AZOMC/fyp-robotic-weed-control/assets/detections_sample.jpg

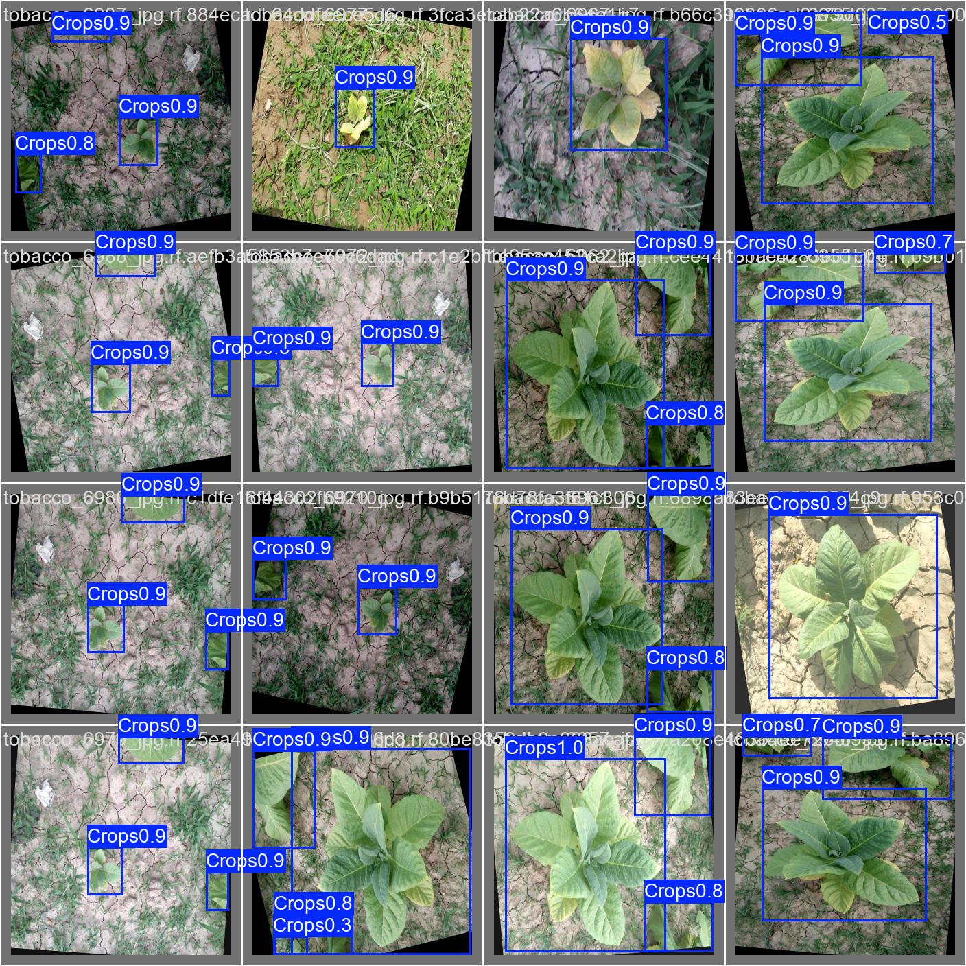
assets/detections_sample.jpg
