AZOMC/fyp-robotic-weed-control/assets/f1_curve.png

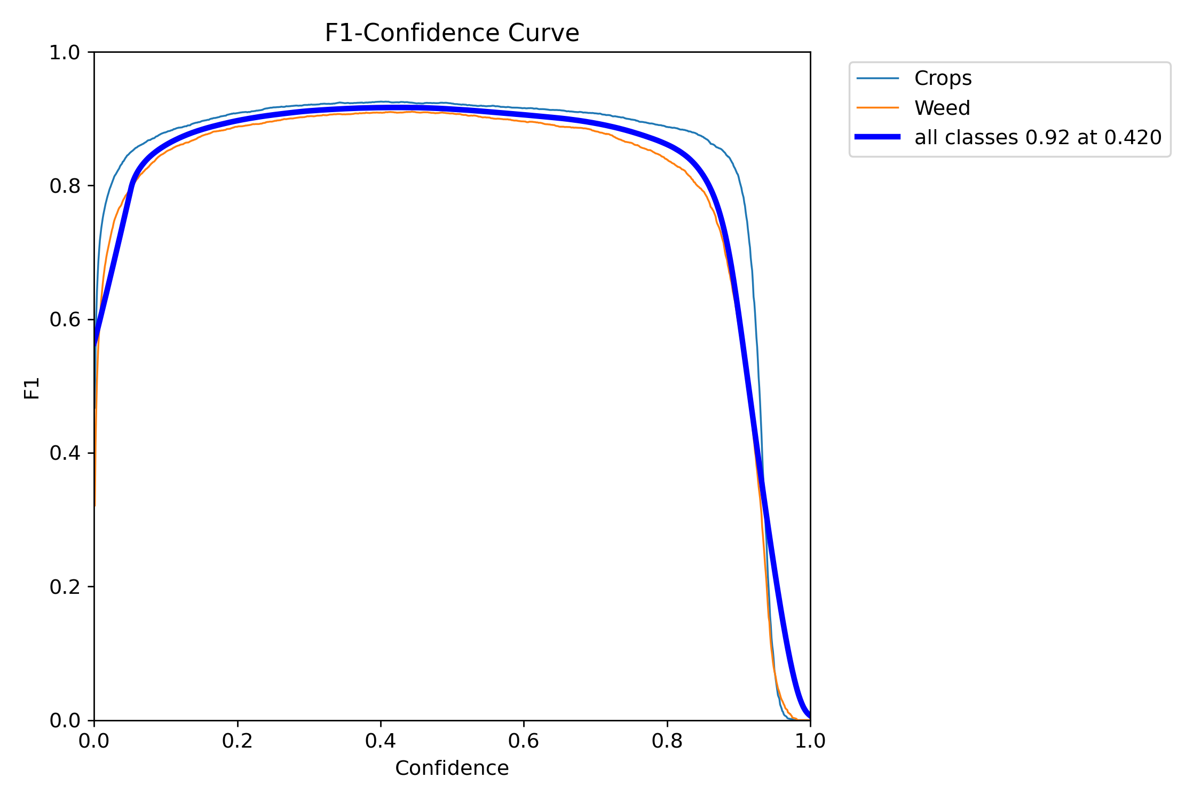
assets/f1_curve.png
