AZOMC/fyp-robotic-weed-control/assets/project_flowchart.png

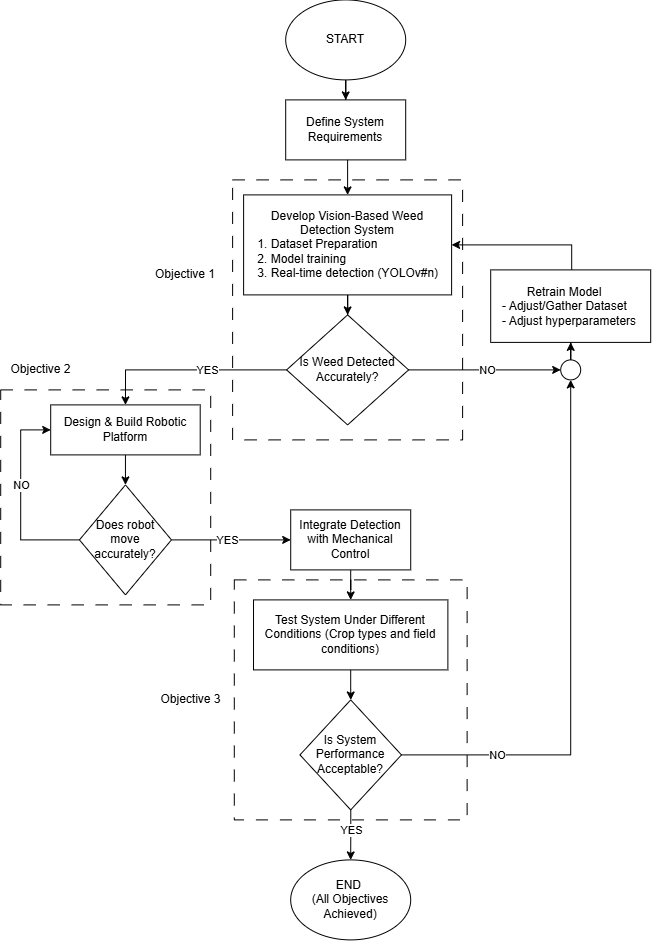
assets/project_flowchart.png
