AZOMC/fyp-robotic-weed-control/assets/training_curves.png

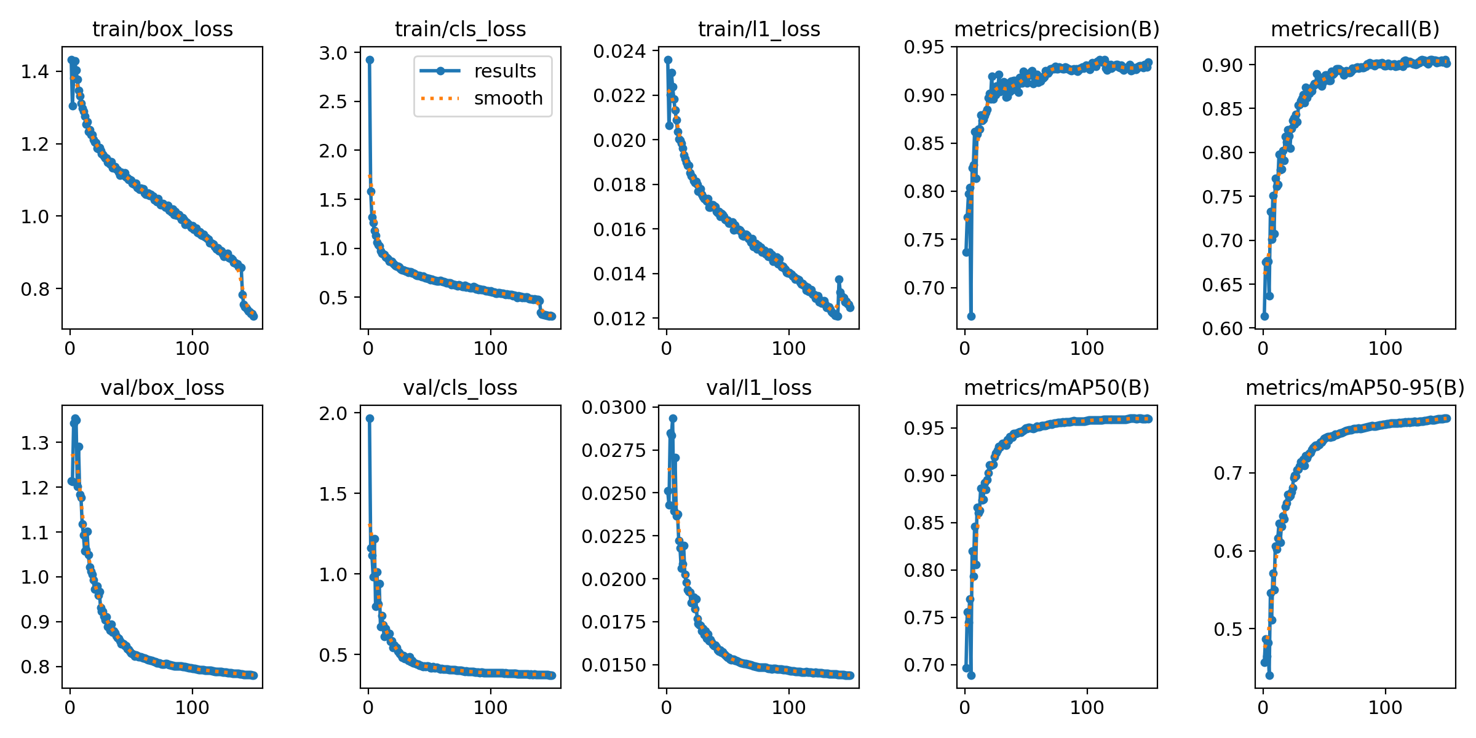
assets/training_curves.png
