AZOMC/fyp-robotic-weed-control/docs/benchmark_results_clean_power.csv

label | imgsz | avg_ms | min_ms | max_ms | fps
v2_ncnn_320 | 320 | 101.49 | 100.45 | 107.17 | 9.85
v2_ncnn_640 | 640 | 398.34 | 387.78 | 413.93 | 2.51
v3_ncnn_320 | 320 | 95.67 | 92.49 | 124.79 | 10.45
v3_onnx_320 | 320 | 105.23 | 102.92 | 119.07 | 9.50
