AZOMC/fyp-robotic-weed-control/docs/training_results_yolo11n.csv

epoch | time | train/box_loss | train/cls_loss | train/dfl_loss | metrics/precision(B) | metrics/recall(B) | metrics/mAP50(B) | metrics/mAP50-95(B) | val/box_loss | val/cls_loss | val/dfl_loss | lr/pg0 | lr/pg1 | lr/pg2 | lr/pg3 | lr/pg4 | lr/pg5 | lr/pg6 | lr/pg7
1 | 84.466 | 1.39366 | 1.89989 | 1.40653 | 0.7765 | 0.68365 | 0.75237 | 0.49625 | 1.18855 | 1.1065 | 1.1835 | 0.00995652 | 0.00331884 | 0.00995652 | 0.00331884 | 0.00995652 | 0.00331884 | 0.00995652 | 0.00331884
2 | 168.26 | 1.26957 | 1.12392 | 1.29443 | 0.73031 | 0.63529 | 0.6914 | 0.42338 | 1.3566 | 1.18586 | 1.32493 | 0.0198248 | 0.00660827 | 0.0198248 | 0.00660827 | 0.0198248 | 0.00660827 | 0.0198248 | 0.00660827
3 | 251.247 | 1.33979 | 1.13325 | 1.34271 | 0.43962 | 0.47909 | 0.43323 | 0.23199 | 1.55394 | 4.47857 | 1.56391 | 0.0295611 | 0.0098537 | 0.0295611 | 0.0098537 | 0.0295611 | 0.0098537 | 0.0295611 | 0.0098537
4 | 339.157 | 1.34701 | 1.117 | 1.35509 | 0.74465 | 0.52863 | 0.62122 | 0.38242 | 1.3845 | 1.51847 | 1.36521 | 0.029406 | 0.009802 | 0.029406 | 0.009802 | 0.029406 | 0.009802 | 0.029406 | 0.009802
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
