AZOMC/fyp-robotic-weed-control/docs/training_results_yolo26n.csv

epoch | time | train/box_loss | train/cls_loss | train/l1_loss | metrics/precision(B) | metrics/recall(B) | metrics/mAP50(B) | metrics/mAP50-95(B) | val/box_loss | val/cls_loss | val/l1_loss | lr/pg0 | lr/pg1 | lr/pg2 | lr/pg3 | lr/pg4 | lr/pg5 | lr/pg6 | lr/pg7
1 | 99.5173 | 1.43272 | 2.92845 | 0.0236 | 0.73692 | 0.61347 | 0.69635 | 0.45681 | 1.21433 | 1.9667 | 0.02511 | 0.00995652 | 0.00331884 | 0.00995652 | 0.00331884 | 0.00995652 | 0.00331884 | 0.00995652 | 0.00331884
2 | 190.828 | 1.30464 | 1.57955 | 0.02065 | 0.77294 | 0.67494 | 0.75536 | 0.48651 | 1.21309 | 1.15961 | 0.0243 | 0.0198248 | 0.00660827 | 0.0198248 | 0.00660827 | 0.0198248 | 0.00660827 | 0.0198248 | 0.00660827
3 | 283.816 | 1.38141 | 1.31604 | 0.02203 | 0.79721 | 0.67681 | 0.74451 | 0.46492 | 1.34239 | 1.11599 | 0.0285 | 0.0295611 | 0.0098537 | 0.0295611 | 0.0098537 | 0.0295611 | 0.0098537 | 0.0295611 | 0.0098537
4 | 372.157 | 1.42837 | 1.25998 | 0.02301 | 0.80353 | 0.67613 | 0.76894 | 0.48195 | 1.3539 | 0.98249 | 0.02836 | 0.029406 | 0.009802 | 0.029406 | 0.009802 | 0.029406 | 0.009802 | 0.029406 | 0.009802
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
