AZOMC/fyp-robotic-weed-control/(commit log)

2026-09-05 Autonomous weed-picking robot: Pi vision + delta arm firmware
    A YOLO26n detector on a Raspberry Pi 4 converts camera pixels to robot
    millimetres and drives a delta arm over Bluetooth to pluck weeds and bin
    them.
    Contents:
    pi/demo.py vision, autoweeding state machine, arbitration, web UI
    firmware/ Arduino Mega: delta IK, pick cycle, drive, gripper
    training/ train / evaluate / export the detector
    models/ trained weights and the NCNN export used on the Pi
    docs/ architecture, hardware, calibration, full results
    Measured: 0.960 mAP@50, 95.7 ms inference (10.45 FPS) on the Pi 4,
    7.61 s mean pick cycle, 16/16 pluck success, 12/16 bin landing.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
    [benchmark_results_clean_power.csv, benchmark_results_undervoltage.csv, model.ncnn.param, training_results_yolo11n.csv, training_results_yolo26n.csv]
2026-09-07 Update hardware cost details in HARDWARE.md
    Clarified total build cost by excluding Raspberry Pi.
